MKEadmin/Sjoelbak/Documents/03_Org_Sjoelbak_01.jpeg

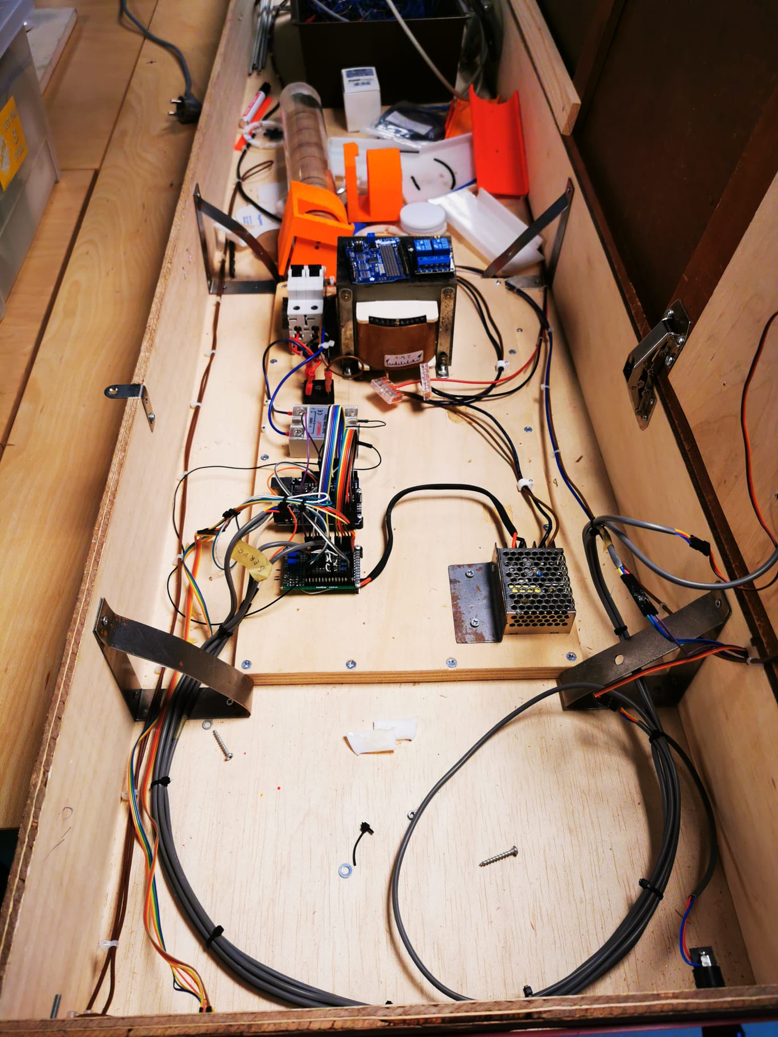
Documents/03_Org_Sjoelbak_01.jpeg
