MKEadmin/Sjoelbak/Documents/03_Org_Sjoelbak_02.jpeg

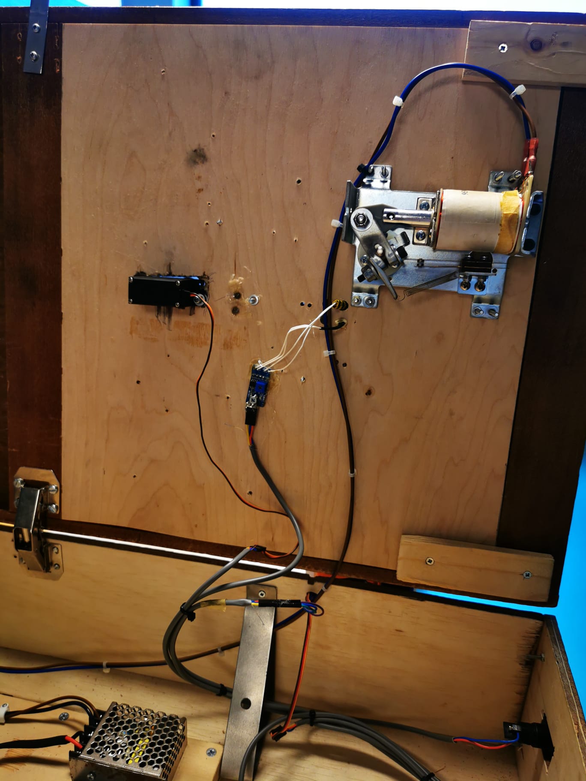
Documents/03_Org_Sjoelbak_02.jpeg
