MKEadmin/Sjoelbak/TIPs/TIPS.docx

TIPS

- ABS boven op aceton printen.
- Plastic (denk aan de plastic rode/witte baan die onder de flipper zit.) buigen eventueel voor beter schiet. De lasersnijder was toen stuk. En er zij 2 plastic buigers.
