MKEadmin/Sjoelbak/Documents/01_Stories.docx

Als <naam> Wil ik <wens> om <reden>

Arjan : Als bejaarde gebruiker wil ik een duidelijk grote knop om Niet bang te zijn om de bak te gebruiken.

Samuel : Als bejaarde gebruiker wil ik het zo eenvoudig mogelijk bedienen om dat ik snel vergeet.

Janiek : Als Open dag bedenker wil ik dat de sjoelbak robust is en altijd werkt om een goede indruk te geven

Senna : Als algemeen gebruiker wil ik gelijk zien wat de bedoeling is om verwarring te voorkomen.

Ilias : Als docent wil ik dat de studenten lol hebben in het project om iet te leren en dat iedereen meedoet.

Lars : Als docent wil ik dat alle studenten meedoen en inbreng geven omdat een groepsprestatie neerzetten.

Jelmer : Als kind wil ik allemaal gave lichtjes zien om omdat het er gaaf en aantrekkelijk uitziet

Stan : Als luie gebruiker wil ik dat de “geen score” stenen weer teruggeduwd worden na een beurt omdat ik niet van mijn stoel af wil.

Arda : Als student wil ik dat het leuk ik omdat bij een leuk project leer ik meer.

Bas : Als intensieve gebruiker wil ik dat het makkelijk, en leuk is want wil ik ledjes zien en heel de dag bezig gehouden worden. (verslavend iets)

Sadra : Als (onderhouds) monteur wil ik dat de techniek overzichtelijk is omdat ik snel diagnose kan maken.

Sadra Als monteur wil ik dat ik NOOIT opgeroepen wordt, omdat de sjoelbak het altijd probleemloos doet.

Rins : Als algemene gebruiker wil ik veel interactie om verveling te voorkomen.

Als (bejaarde) gebruiker wil ik dat meerdere sjoelbakken met elkaar kunnen communiceren omdat ik dan met iemand naast me kan spelen op onze eigen bak.

Als gebruker wil ik dat het gewicht van de bak klein blijft zodat ik het makkelijk kan opbergen.

Als eigenaar wil ik dat de bak robust is, zodat ik het makkelijk kan verplaatsen en opruimen.
