MKEadmin/Sjoelbak/Documents/GithubQrSjoelbak.docx

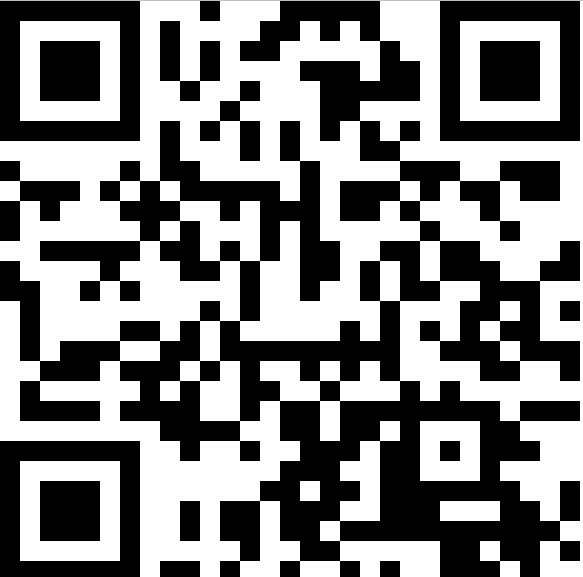
[picture p14: figure]

1. Maak een github account aan
2. Toegevoegd worden aan het bord door A Kamberg
3. Scan de qr code
