MKEadmin/Sjoelbak/Documents/Werking Flipper.jpeg

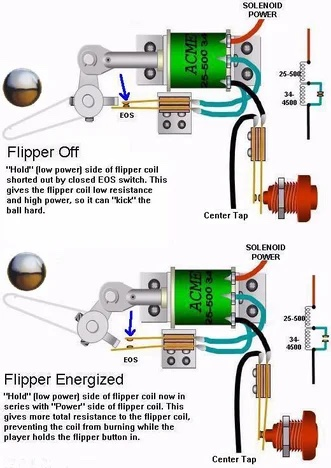
Documents/Werking Flipper.jpeg
