MKEadmin/Sjoelbak/Documents/05_Materialen_Lijst_sjoelbak.ods

Onderdeel | Naam | Merk | Aantal | Link pdf
Two-stage general performance EMI filter | FN 660-6/06 | schaffner | 1 | Datasheets/05_schaffner_FN660-606_datasheet
Raspberry Pi Pico | Pico | Raspberrry Pi Trading Ltd | 2 | Datasheets/05_pico-datasheet
Pro M Compact Installatieautomaat | S203C-B6 | ABB | 1 | Datasheets/05_installatieautomaat_datasheet
Solid state relais | SSR-25 DD | YANGJI | 1 | Datasheets/05_YANGJI_SolidStateRelay_datasheet
Spoel | FL-17636 | multigame speelautomaten | 1 | geen datasheet beschikbaar
wissel richter | SPS G050-24 | SunPower Technologies | 1 | Datasheets/05_SunPowerTechnologies_SPS G050-24_datasheet
detectie sensor | Flying-Fish | Robosoft Systems | 10 | Datasheets/05_Flying-Fish_sensor_datasheet
BrugGelijkrichter | TC-KBPC10/15/2502FP | TRU Components | 1 | Datasheets/05_BrugGelijkrichter_datasheet
