MKEadmin/Sjoelbak/Fusion/glijbaan v3.stl

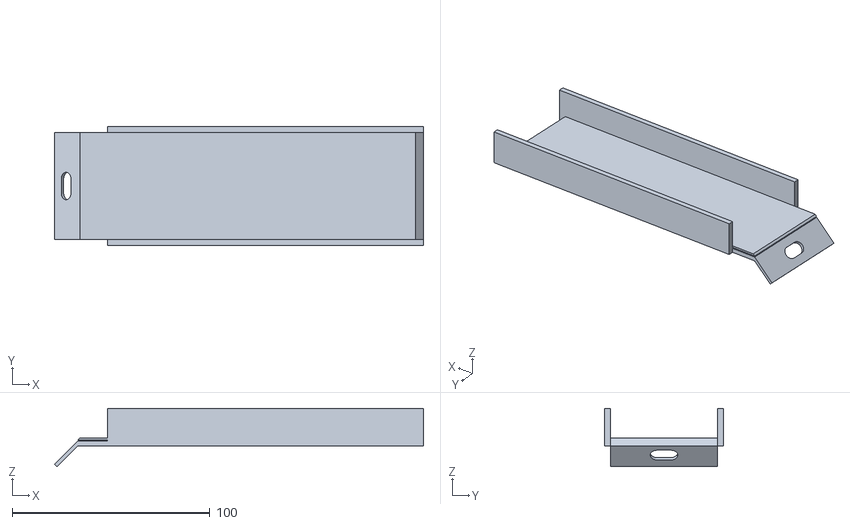
[picture p16: CAD file, 2023-09-17]
Fusion/glijbaan v3.stl
186.8 x 60.0 x 29.6
