MKEadmin/Sjoelbak/Fusion/LedHouder.stl

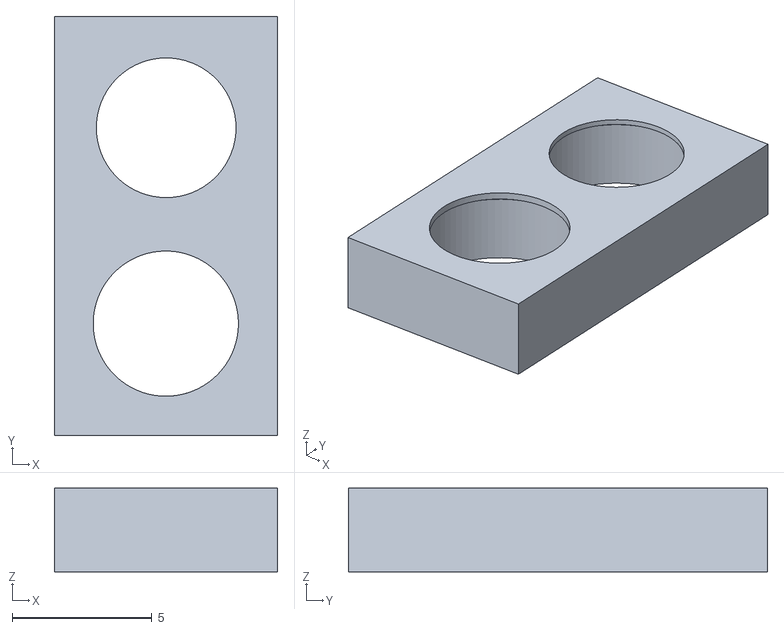
[picture p17: CAD file, 2023-09-17]
Fusion/LedHouder.stl
8.00 x 15.0 x 3.00
