MKEadmin/Sjoelbak/Fusion/GlijbaanSjoelsteen.stl

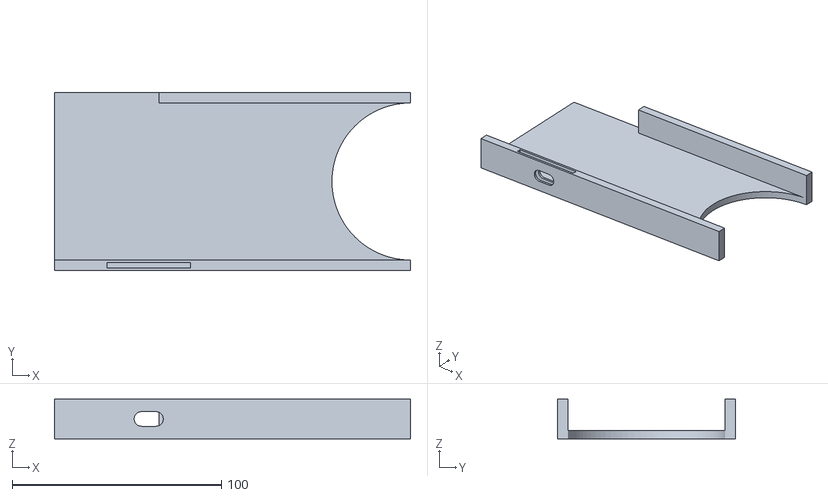
[picture p18: CAD file, 2023-09-17]
Fusion/GlijbaanSjoelsteen.stl
170.0 x 85.0 x 19.0
