MKEadmin/Sjoelbak/(list of files, cad)

Other CAD files:
Fusion/Frontplate.f3d
Fusion/Sjoelbak.f3d
