MKEadmin/Sjoelbak/Documents/04_Raspberry_Pi_Pico_5Volt.pdf

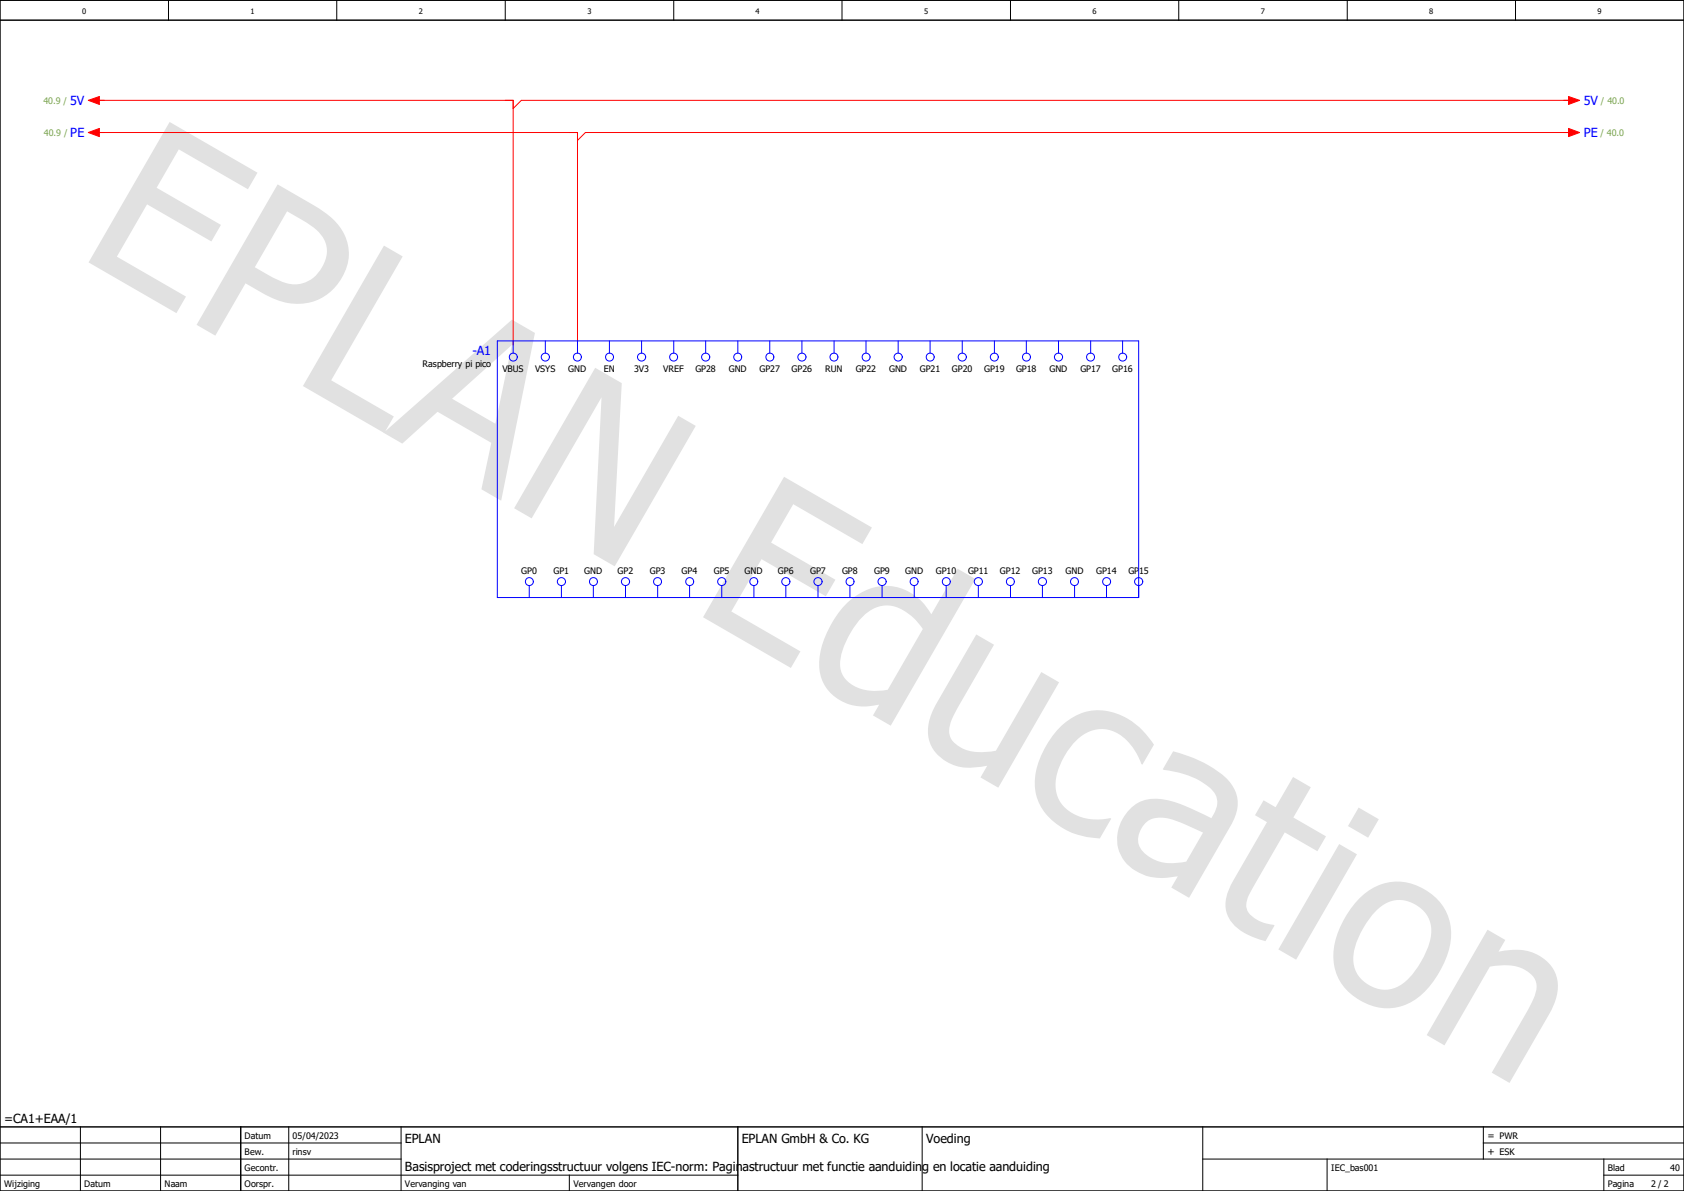
[picture p19: page 1]
=CA1+EAA/1; VBUS VSYS GND; VREF GP28 GND GP27 GP26; RUN; GP22 GND GP21 GP20 GP19 GP18 GND; GND; GND GP10 GP11 GP12 GP13 GND GP14 GP15

Raspberry pi pico

Datum | 05/04/2023 | EPLAN Basisproject met coderingsstructuur volgens IEC-norm: Paginastructuur met functie aanduiding en locatie aanduiding | EPLAN GmbH & Co. KG | Voeding | = PWR
Bew. | rinsv | | | | + ESK
Gecontr. | | | | | IEC_bas001 | Blad 40

Wijziging | Datum | Naam | Oorspr. | | Vervanging van | Vervangen door | | | | Pagina 2 / 2
