MKEadmin/Sjoelbak/Documents/flipper circuit.pdf

5V voeding | 50V voeding

-T1

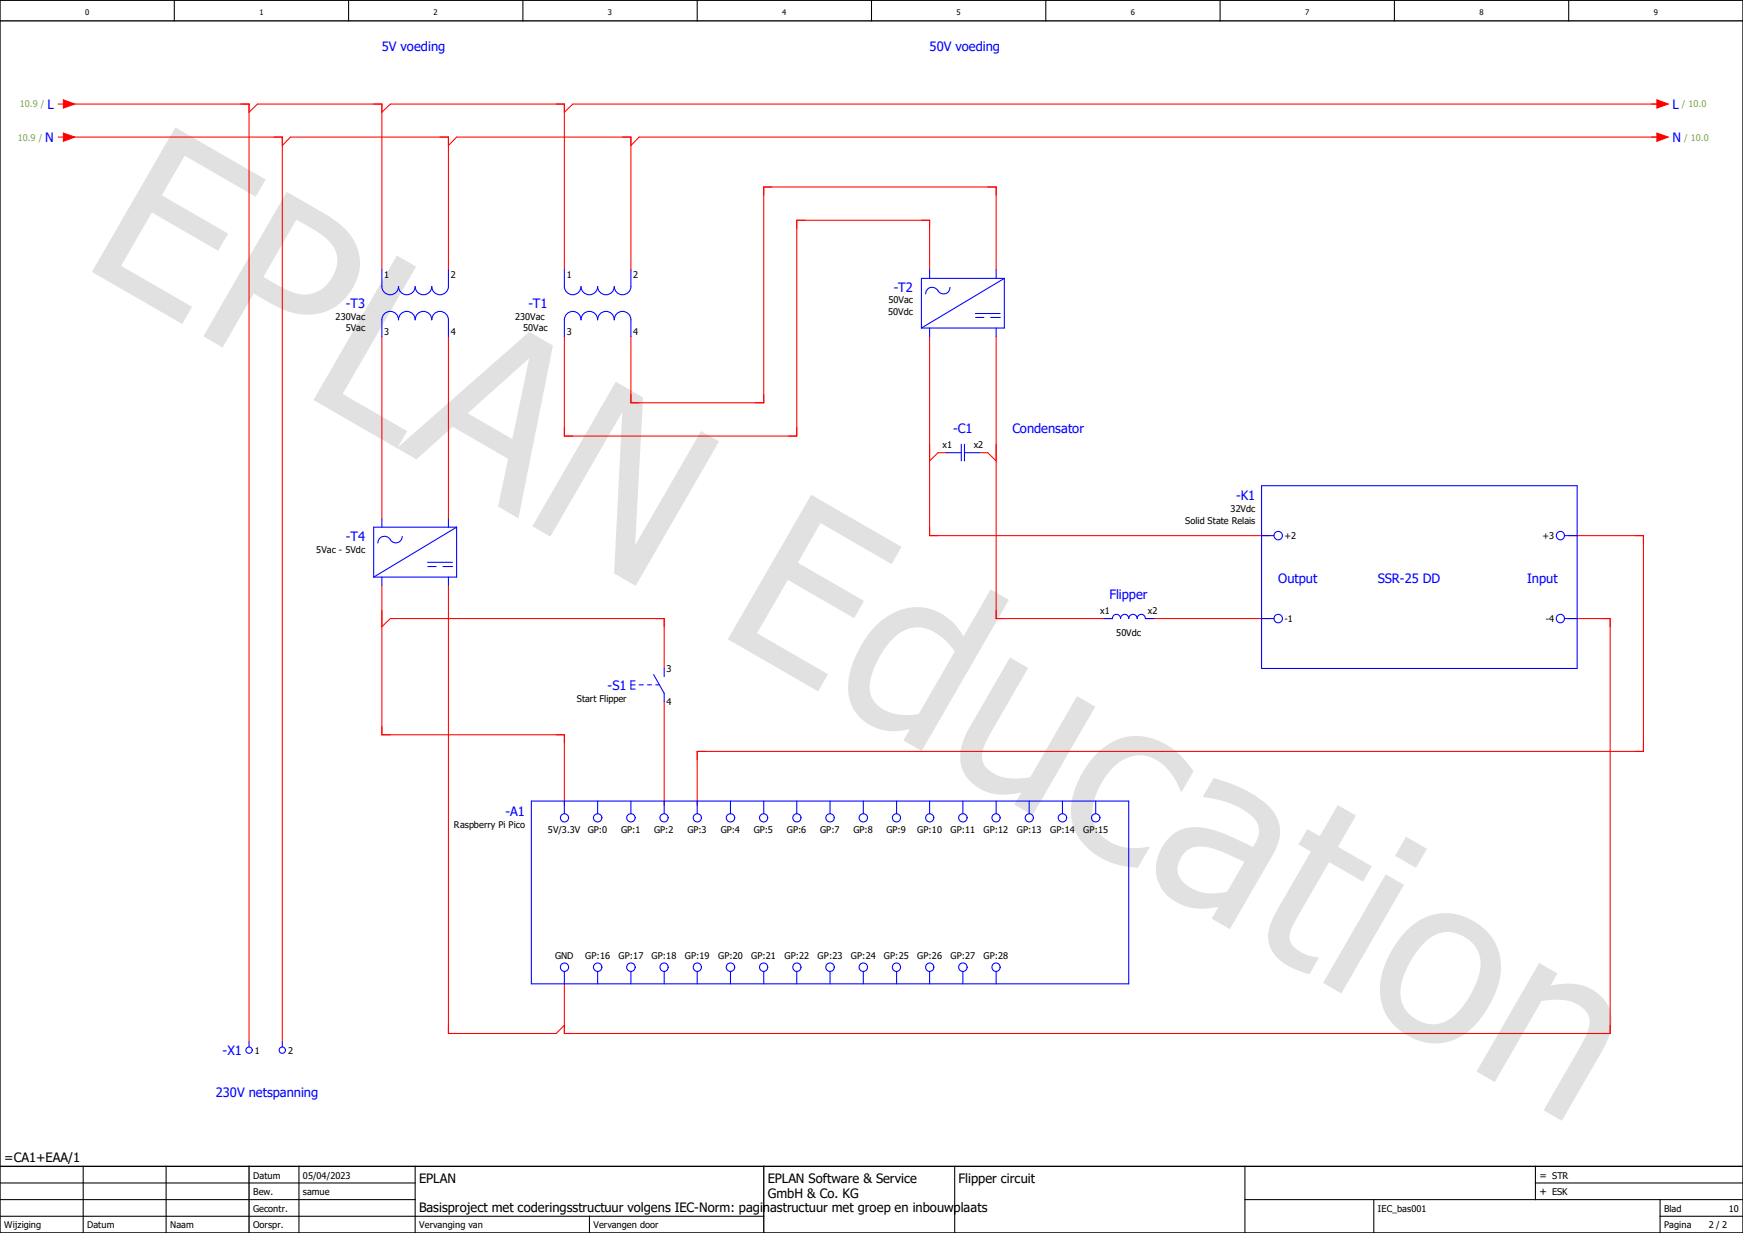
[picture p20: page 1]
Pagina Basisproject met coderingsstructuur volgens IEC-Norm: paginastructuur met groep en inbouwplaats Bew. =CA1+EAA/1; Oorspr.; IEC_bas001 EPLAN; Vervangen door; STR; Gecontr.; Vervanging van; SSR-25 DD ⁺²; -A1 Raspberry Pi Pico; 5V/3.3V GND; Output; Input; Condensator; 230V netspanning; 230Vac 50Vac; -T2 50Vac 50Vdc; 50Vdc Flipper x1; -T3 230Vac 5Vac; 5Vac - 5Vdc; -S1 Start Flipper

32Vdc Solid State Relais

Datum | 05/04/2023 | EPLAN Software & Service GmbH & Co. KG | Flipper circuit | =

samue | | | + ESK

Blad 10

Wijziging | Datum | Naam | | | | | | 2 / 2
