MKEadmin/Sjoelbak/Documents/Sjoelbak tekenpakket.pdf

+49 (0)2173 - 39 64 - 0

40789

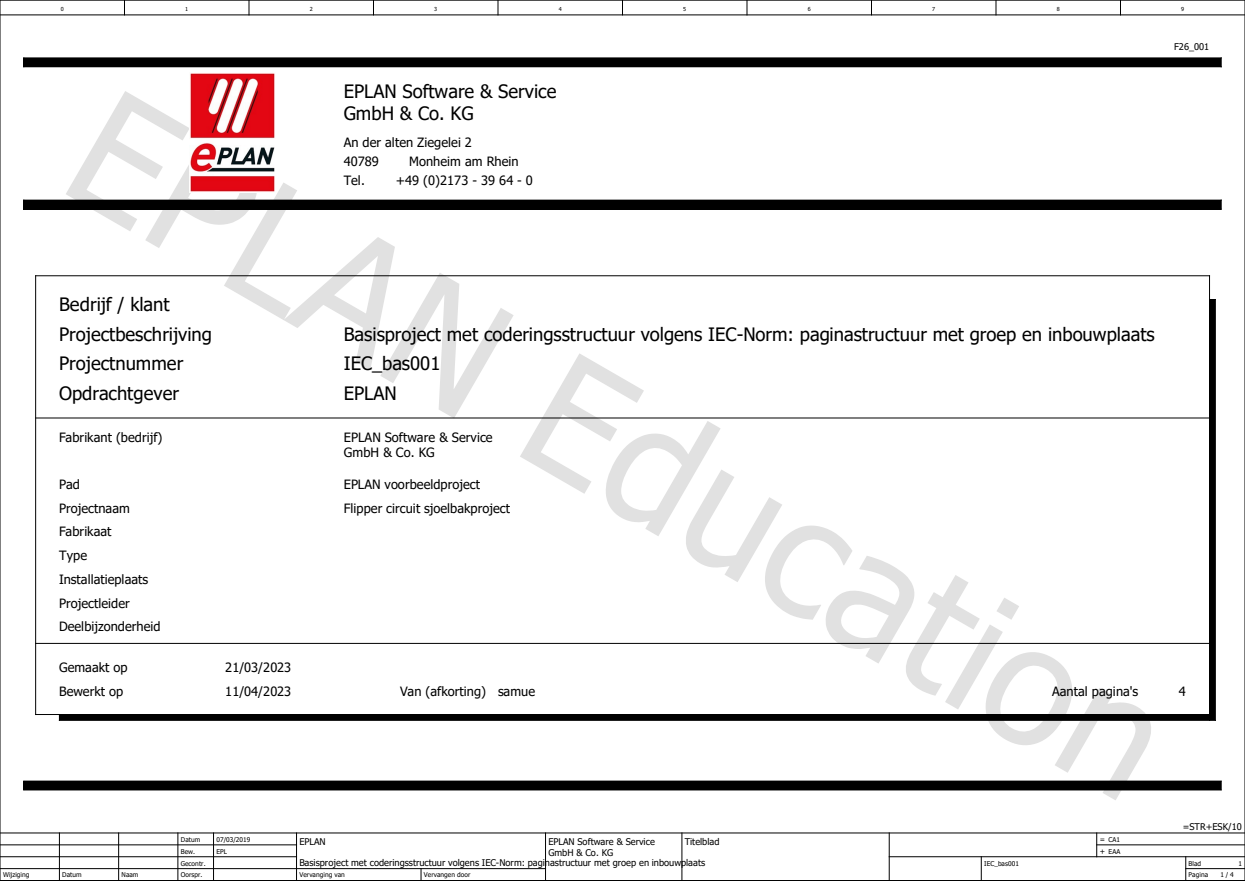
[picture p21: page 1]
Pagina Basisproject met coderingsstructuur volgens IEC-Norm: paginastructuur met groep en inbouwplaats Bew. Oorspr.; IEC_bas001 EPLAN; Vervangen door; CA1 EAA; Gecontr.; Vervanging van; 4 =STR+ESK/10; Projectbeschrijving; Basisproject met coderingsstructuur volgens IEC-Norm: paginastructuur met groep en inbouwplaats; Aantal pagina's; Opdrachtgever; Bewerkt op; IEC_bas001; Gemaakt op; Projectnummer; EPLAN voorbeeldproject; Fabrikaat; samue; Deelbijzonderheid; Pad; Fabrikant (bedrijf)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

EPLAN Software & Service
GmbH & Co. KG

An der alten Ziegelei 2

Monheim am Rhein

Datum | 07/03/2019 | EPLAN Software & Service GmbH & Co. KG | Titelblad | =

EPL | | | +

Blad 1

Wijziging | Datum | Naam | | | | | | 1 /

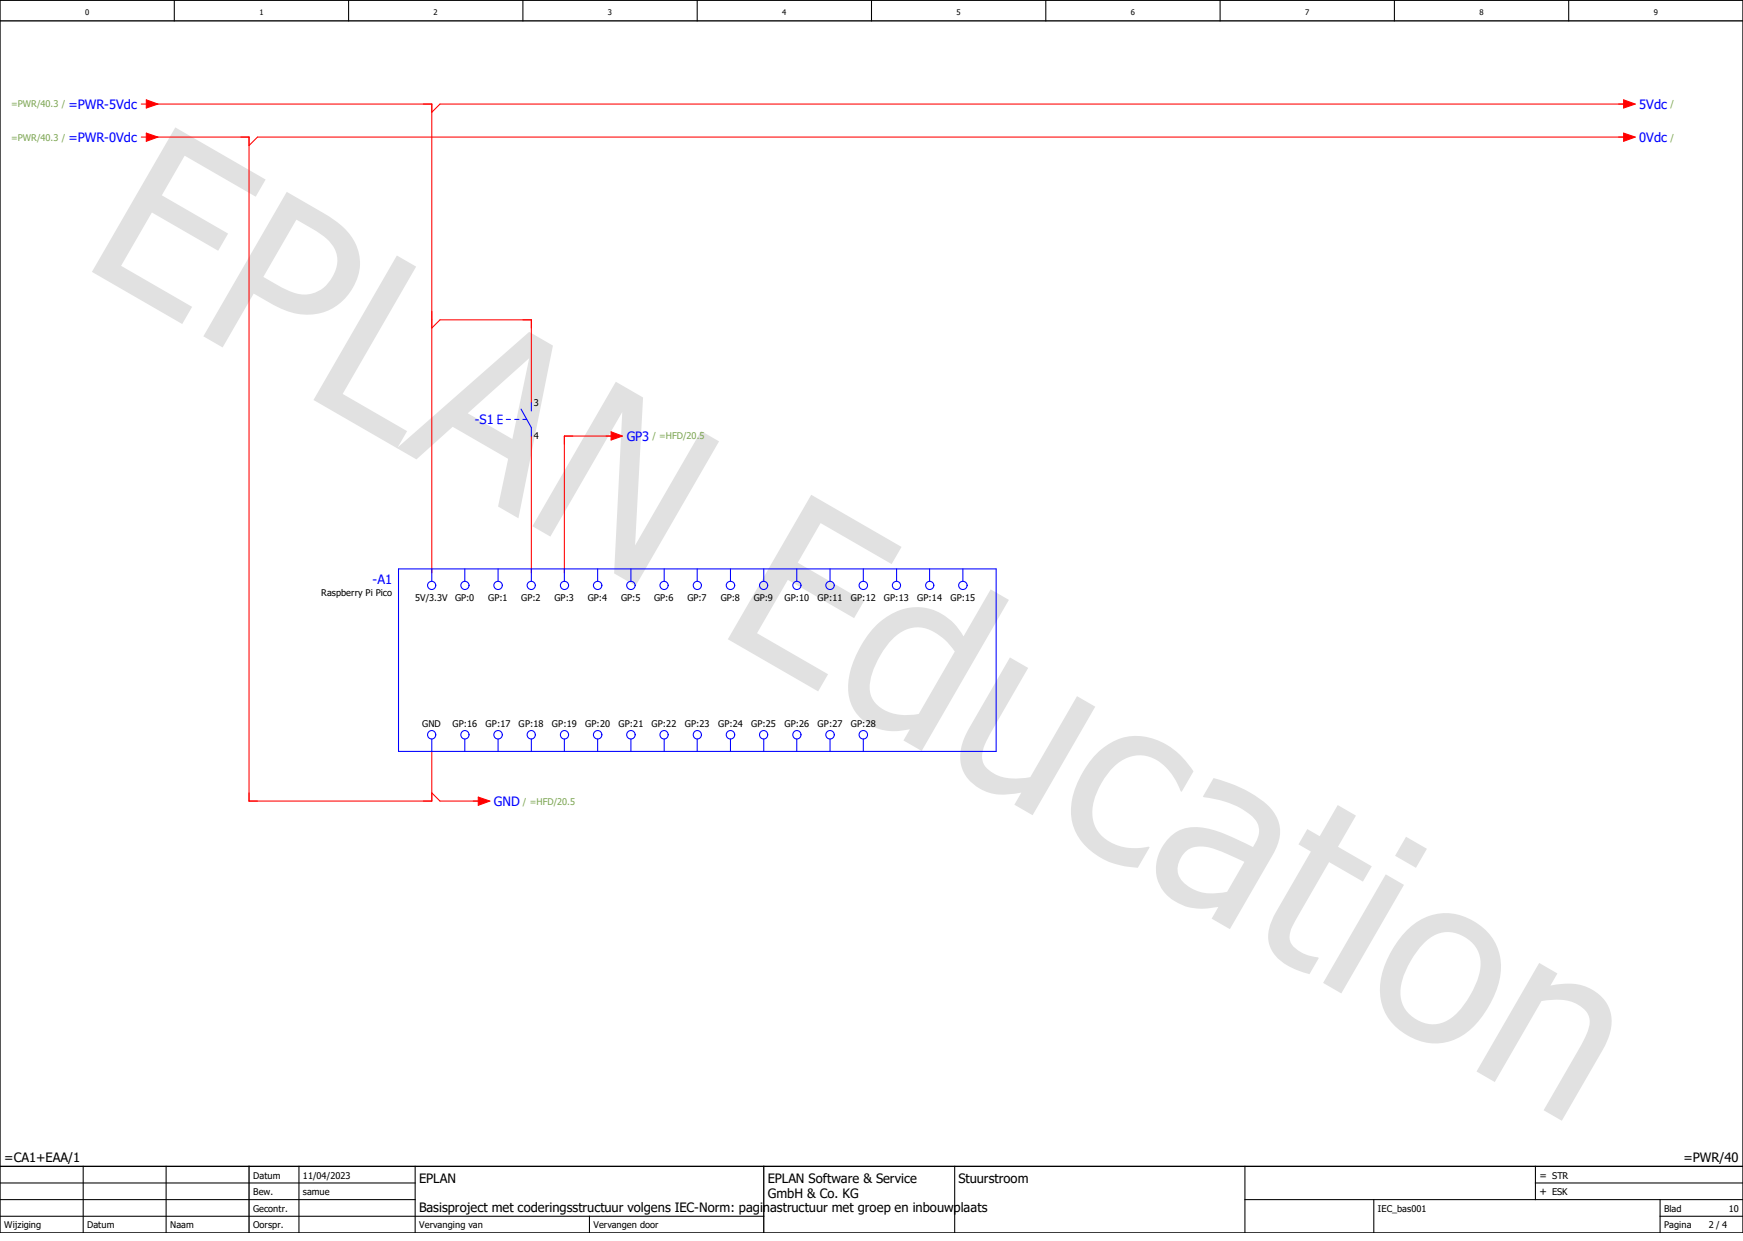
[picture p22: page 2]
Pagina Basisproject met coderingsstructuur volgens IEC-Norm: paginastructuur met groep en inbouwplaats Bew. =CA1+EAA/1; Oorspr.; IEC_bas001 EPLAN; Vervangen door; STR; Gecontr.; Vervanging van; 4 =PWR/40; -A1 Raspberry Pi Pico; 5V/3.3V GND; =PWR/40.3 / =PWR-5Vdc; 5Vdc / =PWR/40.3 / =PWR-0Vdc; 0Vdc / GP3 / =HFD/20.5; GND / =HFD/20.5

Datum | 11/04/2023 | EPLAN Software & Service GmbH & Co. KG | Stuurstroom | =

samue | | | + ESK

Blad 10

Wijziging | Datum | Naam | | | | | | 2 /

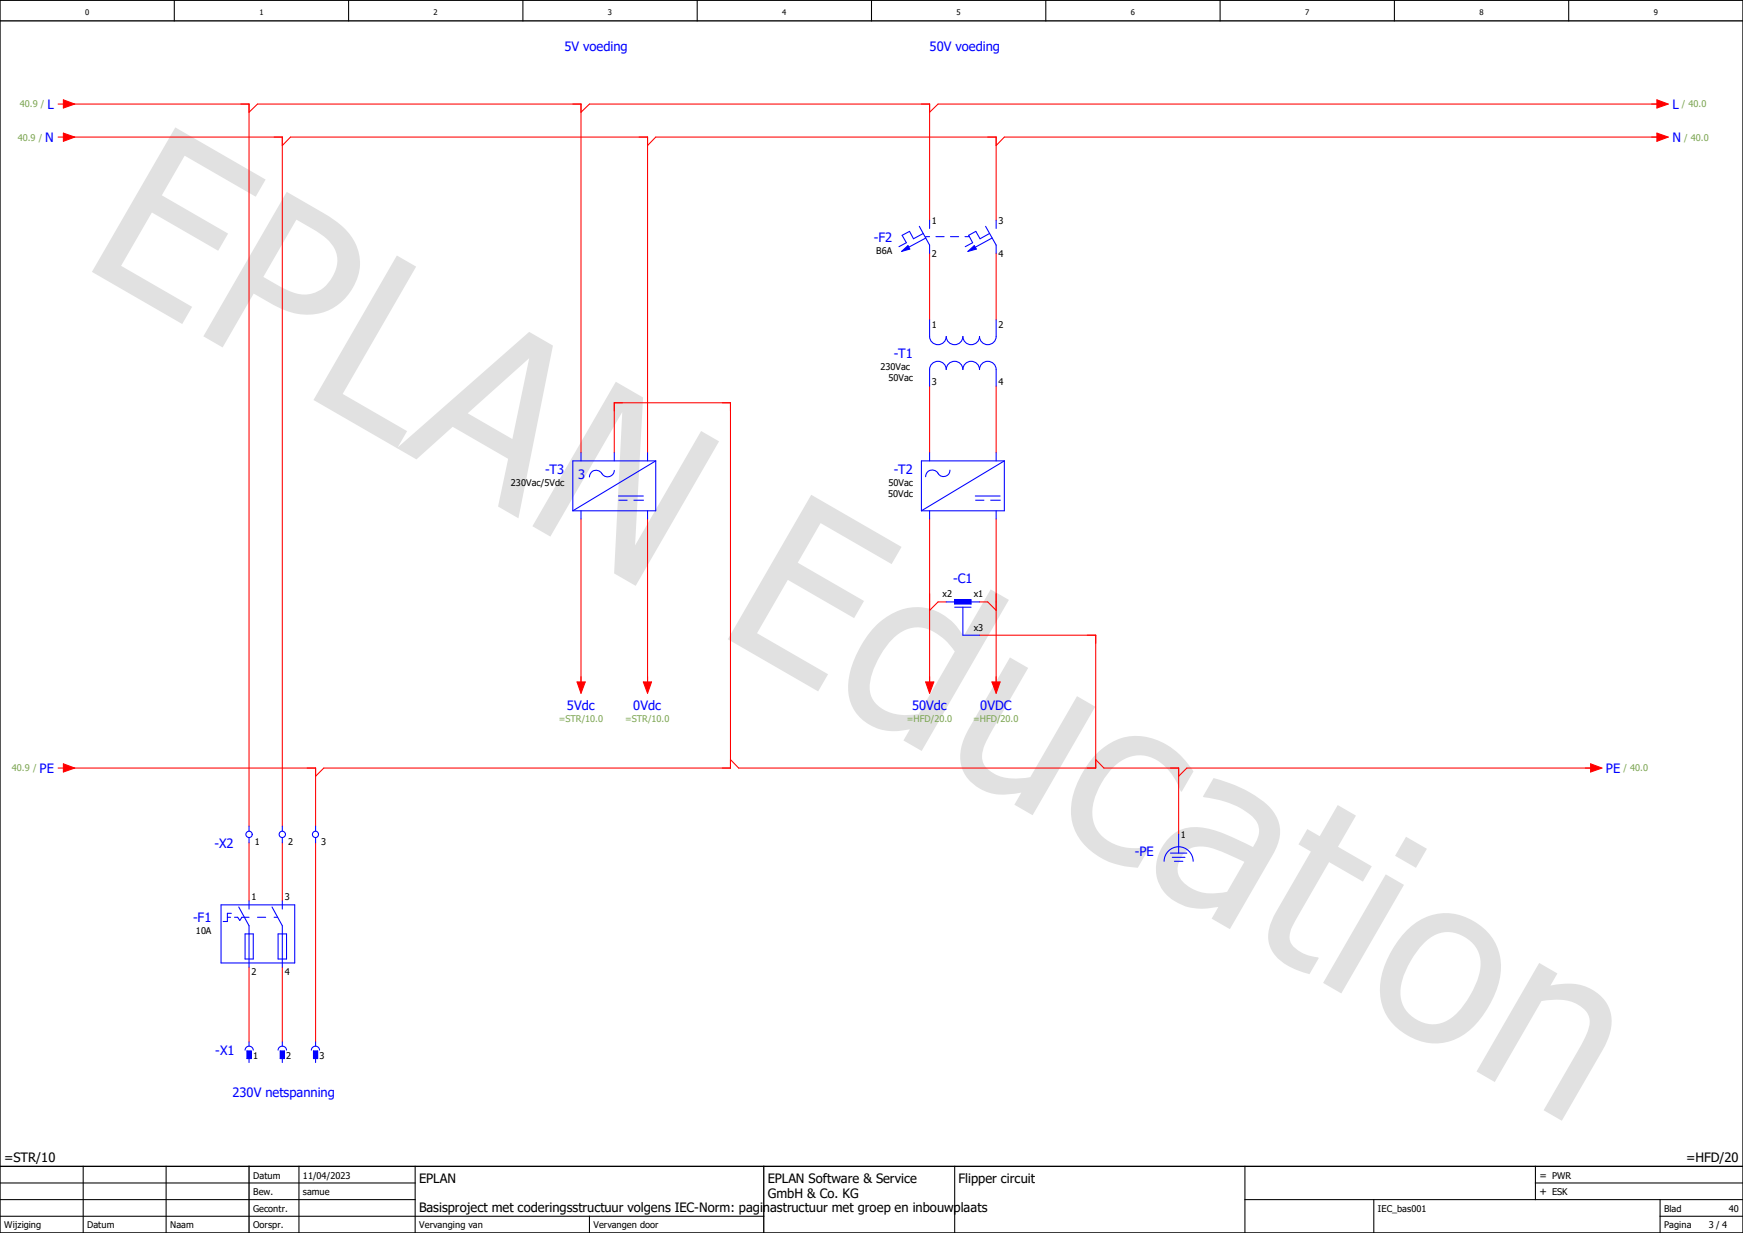
[picture p23: page 3]
Pagina Basisproject met coderingsstructuur volgens IEC-Norm: paginastructuur met groep en inbouwplaats Bew. =STR/10; Oorspr.; IEC_bas001 EPLAN; Vervangen door; PWR; Gecontr.; Vervanging van; 4 =HFD/20; 5V voeding; 50V voeding; 230V netspanning; -T1 230Vac 50Vac; -T2 50Vac 50Vdc; 230Vac/5Vdc; 0Vdc =STR/10.0; 5Vdc =STR/10.0; 50Vdc =HFD/20.0; 0VDC =HFD/20.0

Datum | 11/04/2023 | EPLAN Software & Service GmbH & Co. KG | Flipper circuit | =

samue | | | + ESK

Blad 40

Wijziging | Datum | Naam | | | | | | 3 /

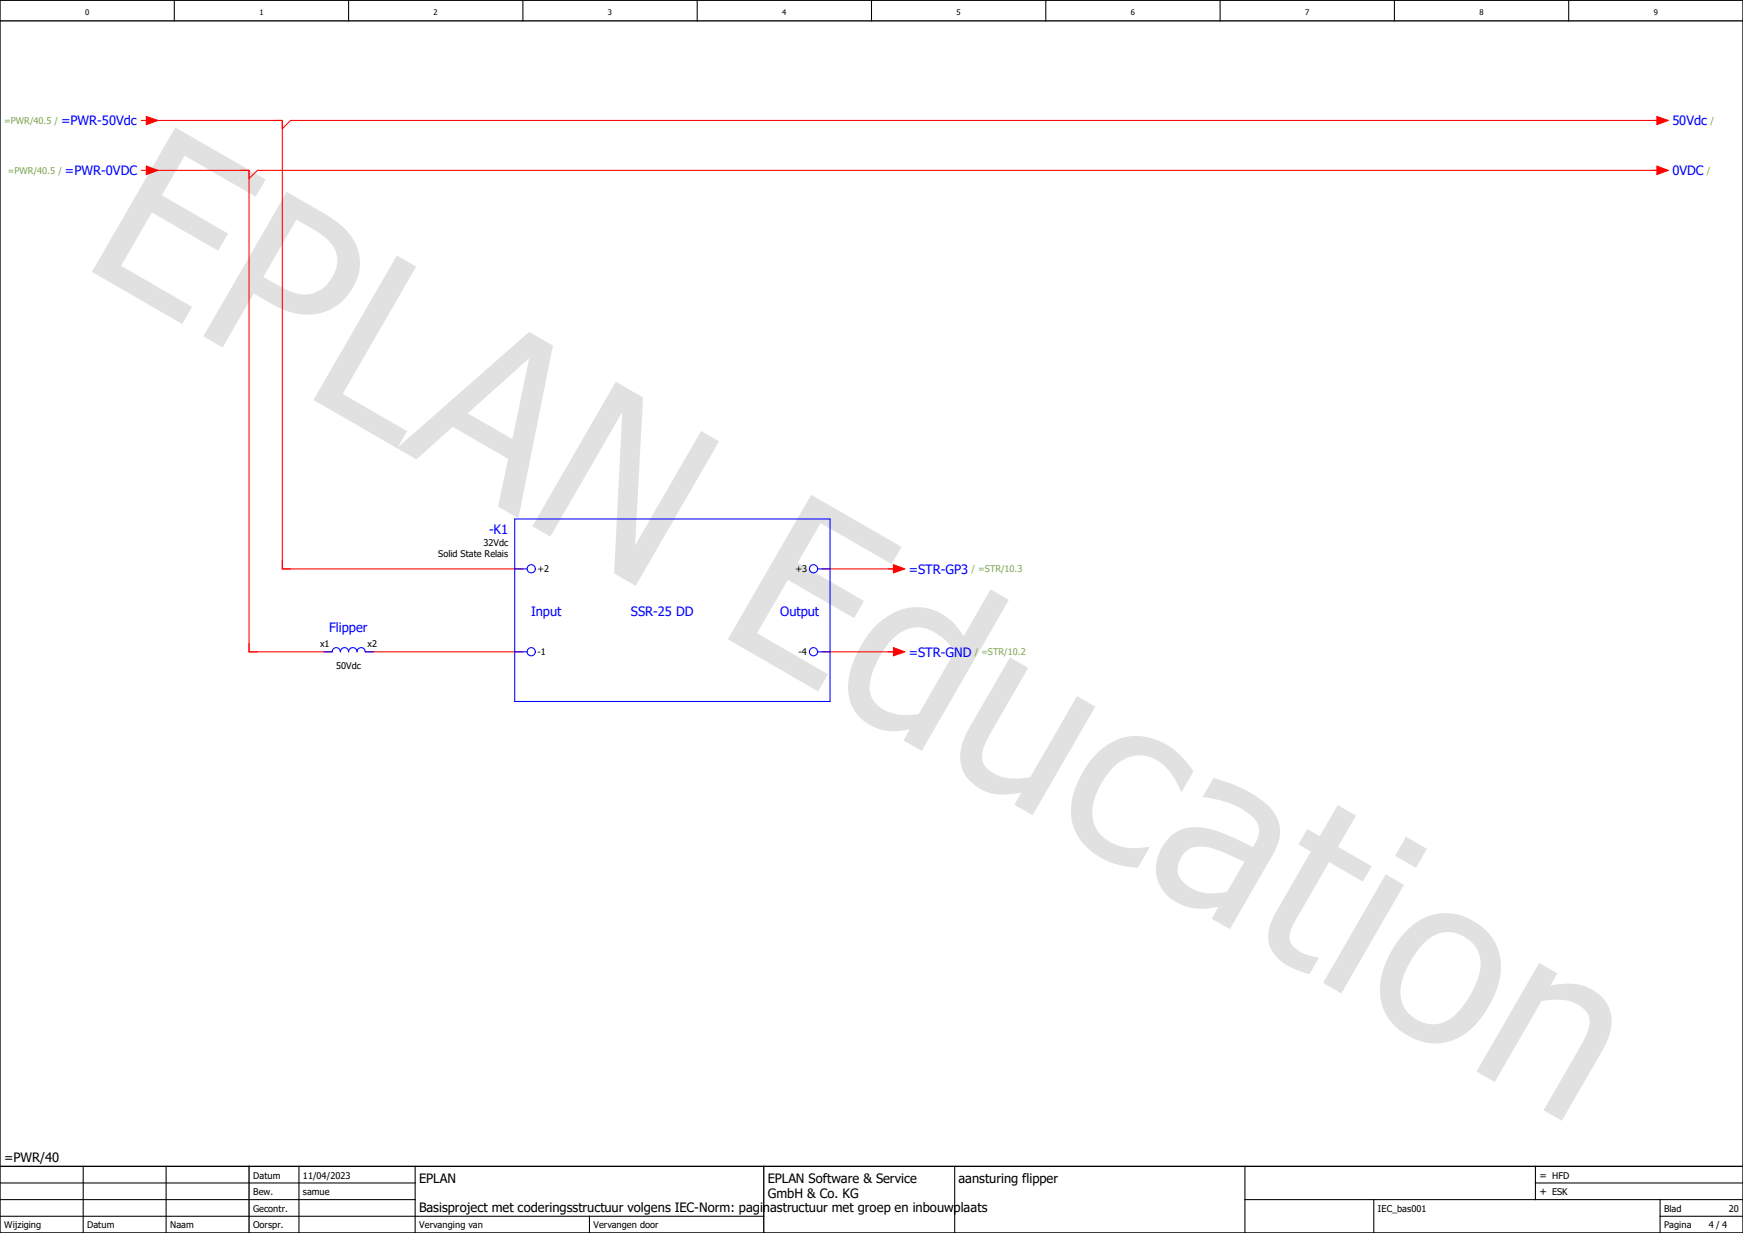
[picture p24: page 4]
Pagina Basisproject met coderingsstructuur volgens IEC-Norm: paginastructuur met groep en inbouwplaats Bew. =PWR/40; Oorspr.; IEC_bas001 EPLAN; Vervangen door; HFD; Gecontr.; Vervanging van; Input; Output SSR-25 DD; 50Vdc Flipper; =PWR/40.5 / =PWR-50Vdc; 50Vdc / =PWR/40.5 / =PWR-0VDC; 0VDC /

32Vdc Solid State Relais

=STR-GP3 / =STR/10.3 =STR-GND / =STR/10.2

Datum | 11/04/2023 | EPLAN Software & Service GmbH & Co. KG | aansturing flipper | =

samue | | | + ESK

Blad 20

Wijziging | Datum | Naam | | | | | | 4 / 4
