MKEadmin/Sjoelbak/microPython/config.py

PIN_0 = 0 # Is in use for the servo reloader
PIN_1 = 1  # is in use for the servo aimer
PIN_2 = 2 # this pin is for the flipperbutton
PIN_3 = 3 # this pin is for the flipper
PIN_4 = 4 #sensor lader
PIN_5 = 5 #sensor schieter
PIN_6 = 6
PIN_7 = 7 
PIN_8 = 8
PIN_9 = 9
PIN_10 = 10 
PIN_11 = 11 
PIN_12 = 12
PIN_13 = 13
PIN_14 = 14 
PIN_15 = 15
PIN_16 = 16
PIN_17 = 17 
PIN_18 = 18
PIN_19 = 19
PIN_20 = 20
PIN_21 = 21 
PIN_22 = 22
PIN_23 = 23
PIN_24 = 24 
PIN_25 = 25
PIN_26 = 26
PIN_27 = 27 
PIN_28 = 28
