MKEadmin/Sjoelbak/microPython/BigMatrixConfig.py

PIN_00 = 0 
PIN_01 = 1 
PIN_02 = 2 # Display
PIN_03 = 3 # Display
PIN_04 = 4 
PIN_05 = 5 # Display
PIN_06 = 6 # IR sensor
PIN_07 = 7 # IR sensor
PIN_08 = 8 # IR sensor
PIN_09 = 9 # IR sensor
PIN_10 = 10 # Display
PIN_11 = 11 # Display
PIN_12 = 12
PIN_13 = 13 # Display
PIN_14 = 14 
PIN_15 = 15
PIN_16 = 16
PIN_17 = 17 
PIN_18 = 18
PIN_19 = 19
PIN_20 = 20
PIN_21 = 21 
PIN_22 = 22
PIN_23 = 23
PIN_24 = 24 
PIN_25 = 25
PIN_26 = 26
PIN_27 = 27 
PIN_28 = 28
